tapansgupta777/2-Stage-OpAmp/Files/OpAmp 30-8.asc

C1: cap; {c}
C2: cap; 2p
I1: current; 20µ
M1: cmosn; l=500n w=3.09u
M2: cmosn; l=500n w=3.09u
M3: cmosp; l=500n w=4.75u
M4: cmosp; l=500n w=4.75u
M5: cmosn; l=500n w=2.85u
M6: cmosn; l=500n w=2.85u
M7: cmosp; l=500n w=63u
M8: cmosn; l=500n w=20u
V1: voltage; 1.8V
V2: voltage; SINE(0.8); AC 1
V3: voltage; SINE(0.8)
Named nets: 0
.include tsmc180nm.lib
.ac dec 100 1k 100G
.op
.step param c 0 800f 20f
