tapansgupta777/2-Stage-OpAmp/(commit log)

2026-08-29 Enhance README with project details and specifications
    Added detailed project description, design specifications, methodology, and simulation results for the Two-Stage CMOS Operational Amplifier.
2026-09-01 Revise README for clarity and formatting improvements
    Updated README with enhanced formatting, added schematic and simulation results sections, and corrected units for clarity.
